GraceBenton04/BAE305_Project_OnlineDesignFile/BAE305_Project_Drawing.pdf

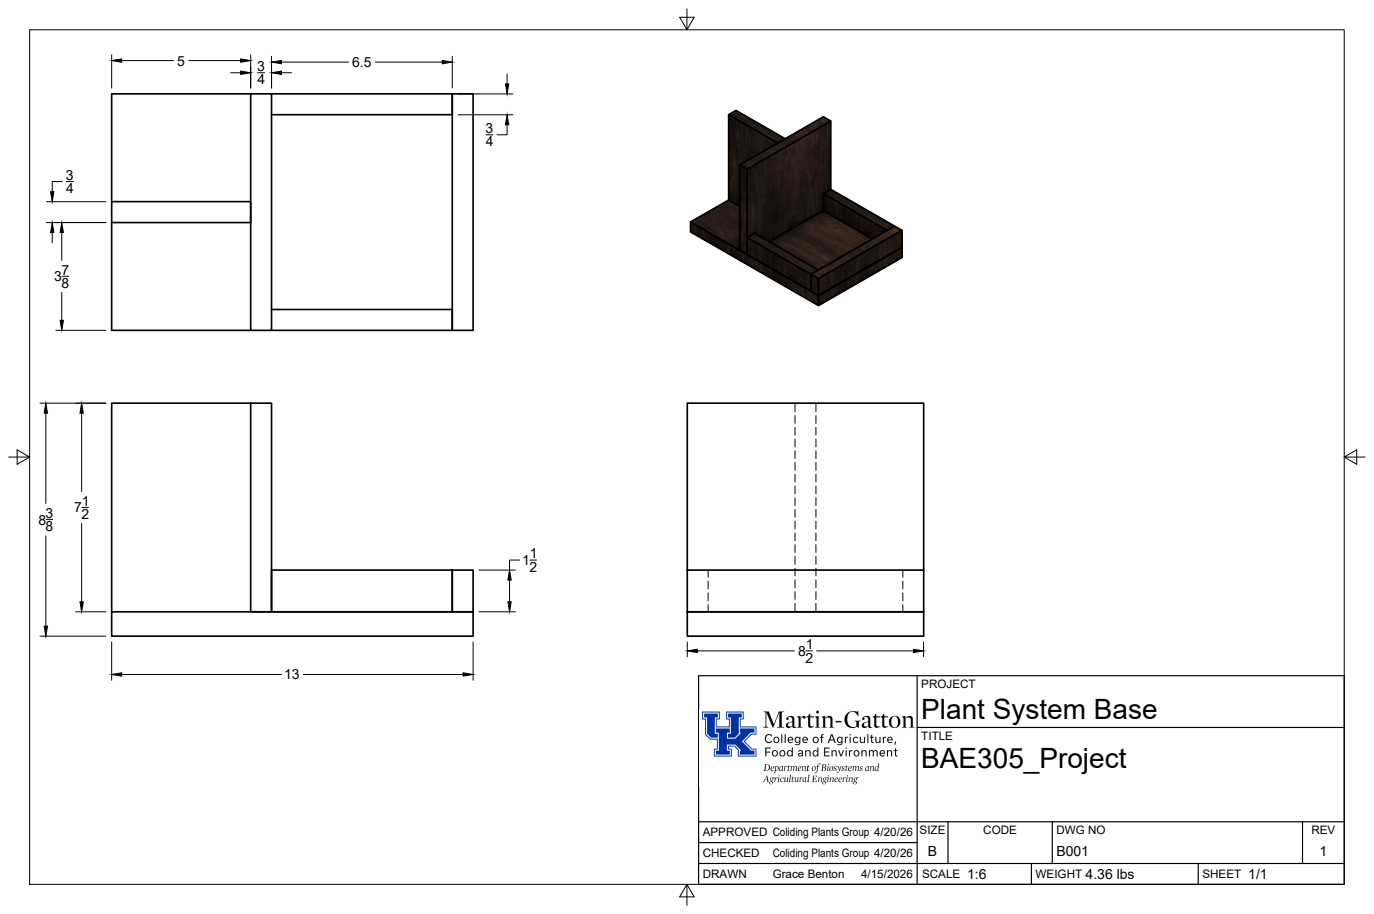
[picture p15: page 1]
SIZE; CODE; DWG NO; REV; Grace Benton; 4.36 lbs; Coliding Plants Group 4/20/26; Plant System Base

Coliding Plants Group 4/20/26
