GraceBenton04/BAE305_Project_OnlineDesignFile/(commit log)

2026-04-21 Add materials list to README
2026-04-21 Update unit formatting for materials section
2026-04-21 Fix formatting of tubing items in README
2026-04-21 Document construction process for plant monitoring system base
    Added detailed construction process for the base of the plant monitoring system, including materials and assembly instructions.
2026-04-22 Update assembly instructions in README
    Added instructions for drilling a hole in the lid.
2026-04-22 Board Schematics
2026-04-22 Board Wire Diagrams
2026-04-22 Update README with Arduino board diagrams
    Added schematic and wiring diagrams for Arduino Boards 1 and 2.
2026-04-22 Revise README with material updates and corrections
    Updated materials list and corrected spelling errors in README.md. Added details about I2C communication and clarified project setup instructions.
2026-04-22 Include code snippets for Board 1 and Board 2
    Added code sections for Board 1 and Board 2 in the README.
2026-04-22 Implement temperature management code for Arduino Board 1
    Added code for Arduino Board 1 to manage temperature settings and display on LCD.
2026-04-22 Update README to link Board 1 code and enhance Board 2 description
    Removed detailed Arduino code for Board 1 from README and provided a link to the full code file. Updated the description for Board 2's moisture sensor and watering system.
2026-04-22 Refine Arduino code section in README
    Updated the README to improve clarity and formatting for the Arduino code section.
2026-04-22 Revise Arduino code references in README
    Updated Arduino code section titles and links in README.
2026-04-23 Revise README with corrections and updates
    Removed design decision discussion section and added details about materials and project setup. Corrected spelling and grammatical errors throughout the document.
2026-04-23 Revise README for clarity and formatting
    Updated materials list format and corrected spelling errors throughout the README. Enhanced clarity in project setup and design decisions.
2026-04-23 Fix code file links for Board 1 and Board 2
    Updated links and descriptions for Board 1 and Board 2 code files in the README.
2026-04-24 Board 2 Code
2026-04-24 Update README.md
    Edited the design discussion section for the water pump system
2026-04-24 Update README.md
    edited test results discussion for board 2
2026-04-25 test wire diagram
2026-04-25 Fix image link in README for thermistor and buzzer
    Updated image link for thermistor and buzzer circuit.
2026-04-25 Fix image syntax for thermistor and buzzer circuit
    Updated image syntax in README for the thermistor and buzzer circuit.
2026-04-25 Revise Walnut Wood quantity and figure references
    Updated material quantity for Walnut Wood and corrected figure references in the testing section.
2026-04-28 updated info on arduino 1
    Corrected spelling errors and improved clarity in the system operation section of the README.
